isolt/AD-15-detector/1.jpg

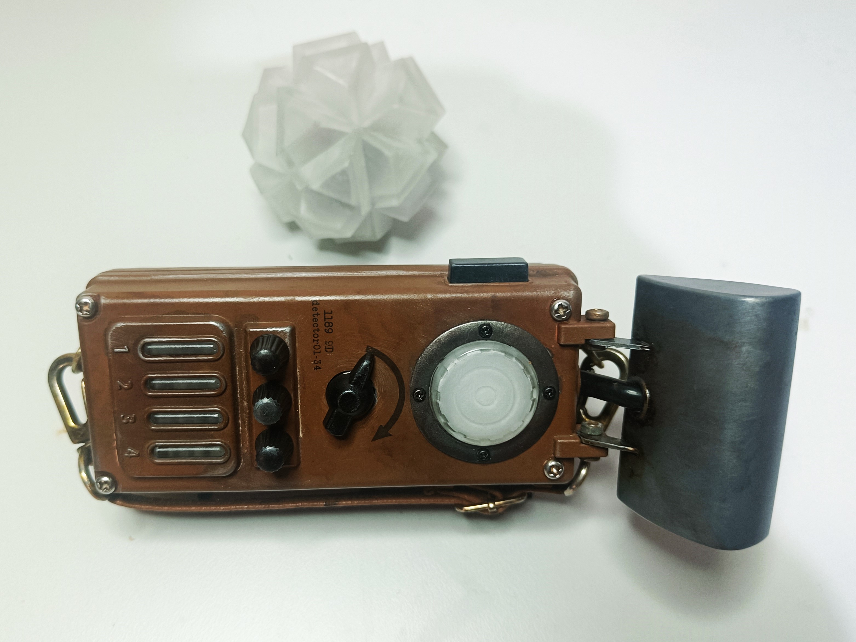
1.jpg
