isolt/AD-15-detector/README.md

# AD-15-detector
Geiger counter like prop from the game "into the radius"
