isolt/AD-15-detector/artifact/Artifact1-Module Cover.STL

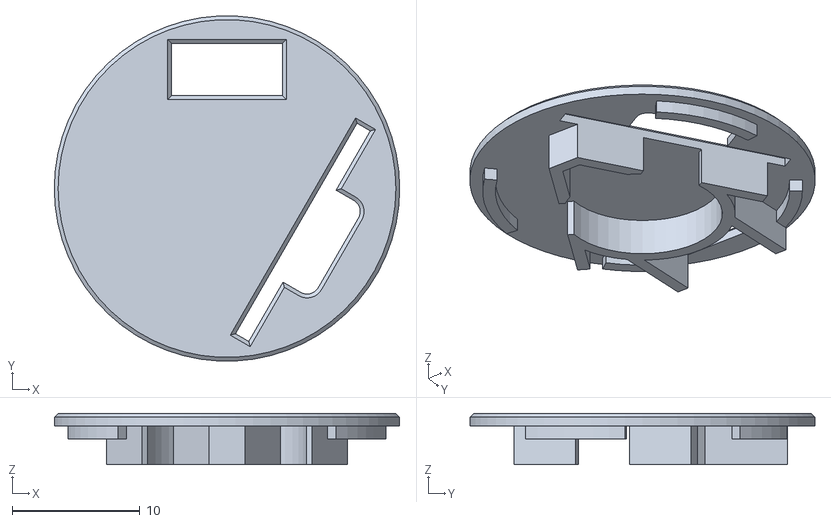
[picture p2: CAD file, 2024-11-29]
artifact/Artifact1-Module Cover.STL
27.0 x 27.0 x 4.00
