isolt/AD-15-detector/detector/DetectorV1-Indicator Diffuser.STL

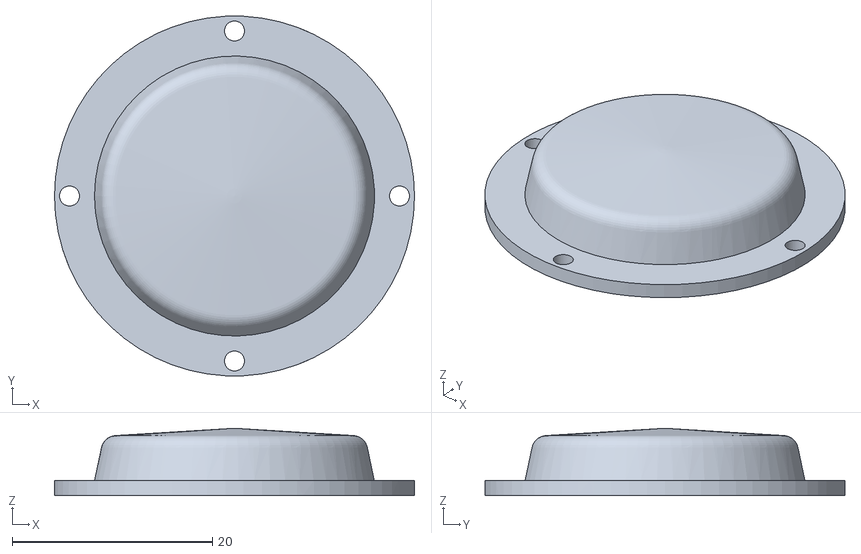
[picture p3: CAD file, 2024-11-29]
detector/DetectorV1-Indicator Diffuser.STL
36.0 x 36.0 x 6.70
