isolt/AD-15-detector/artifact/Artifact1-Module shell.STL

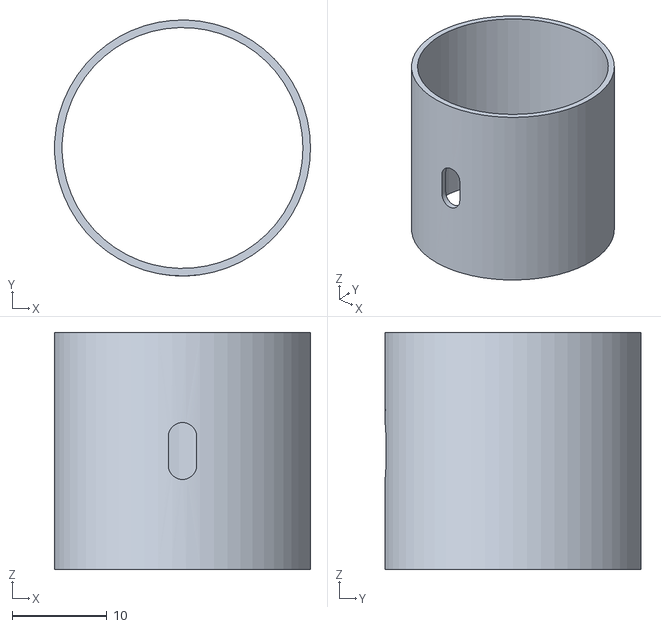
[picture p4: CAD file, 2024-11-29]
artifact/Artifact1-Module shell.STL
27.0 x 27.0 x 25.0
