isolt/AD-15-detector/detector/DetectorV1-Indicator Retainer.STL

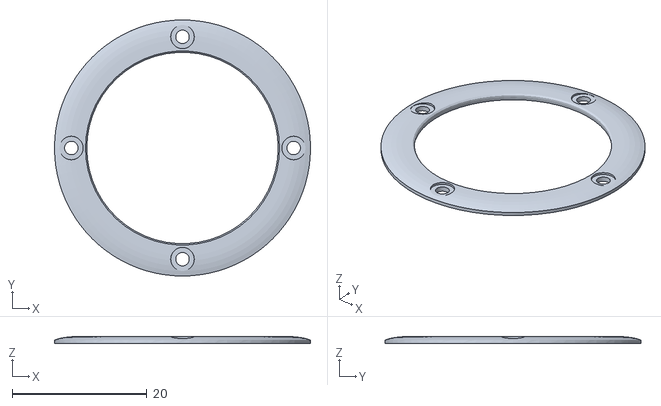
[picture p5: CAD file, 2024-11-29]
detector/DetectorV1-Indicator Retainer.STL
38.0 x 38.0 x 1.00
