isolt/AD-15-detector/artifact/Artifact1-Base.STL

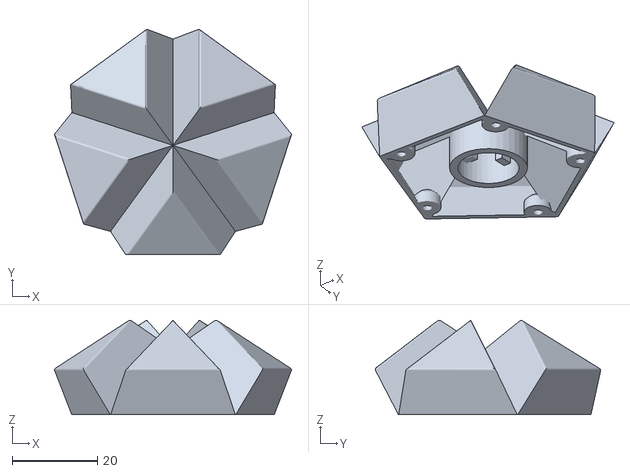
[picture p6: CAD file, 2024-11-29]
artifact/Artifact1-Base.STL
55.5 x 52.8 x 22.1
