isolt/AD-15-detector/detector/DetectorV1-Flash Diffuser.STL

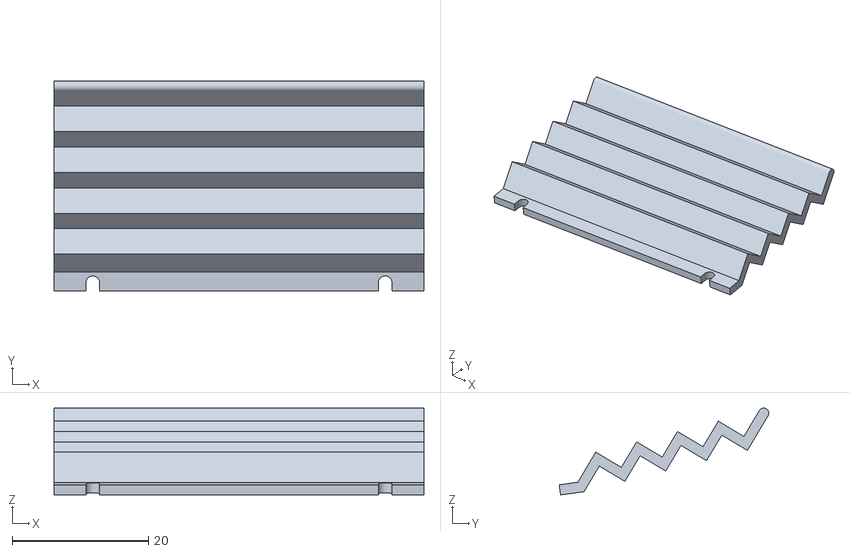
[picture p7: CAD file, 2024-11-29]
detector/DetectorV1-Flash Diffuser.STL
54.4 x 30.8 x 12.8
