isolt/AD-15-detector/artifact/Artifact1-Top.STL

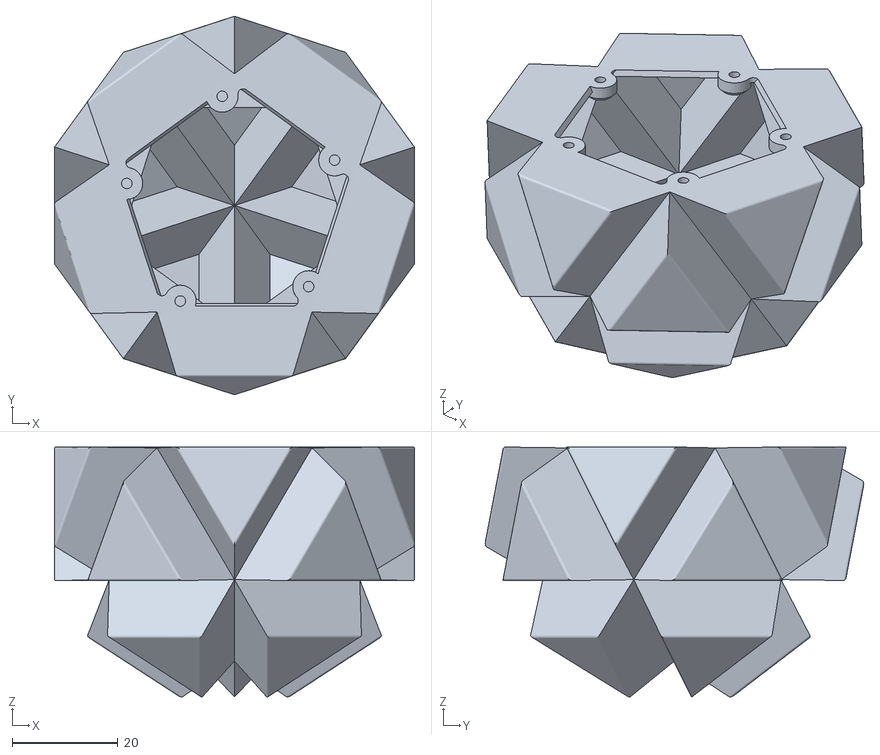
[picture p8: CAD file, 2024-11-29]
artifact/Artifact1-Top.STL
68.0 x 71.5 x 47.2
