isolt/AD-15-detector/detector/DetectorV1-Body Top.STL

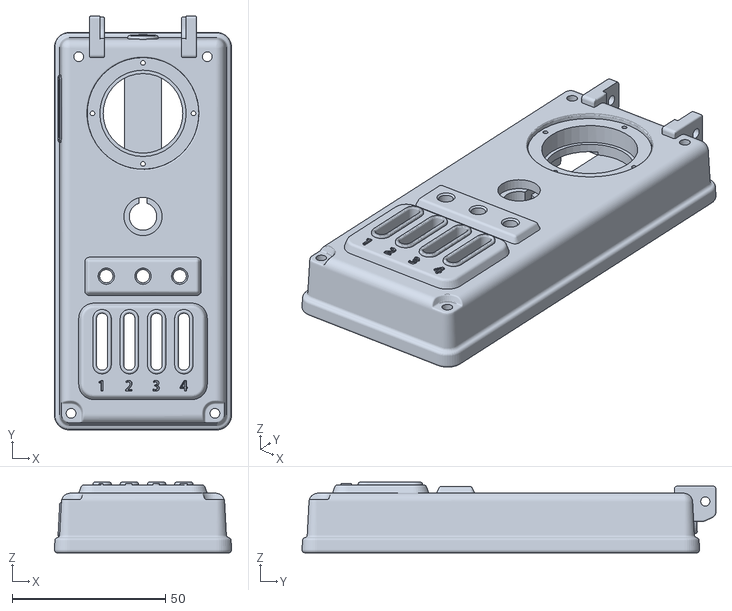
[picture p9: CAD file, 2024-11-29]
detector/DetectorV1-Body Top.STL
57.9 x 135.2 x 23.1
