isolt/AD-15-detector/artifact/Artifact1.STEP

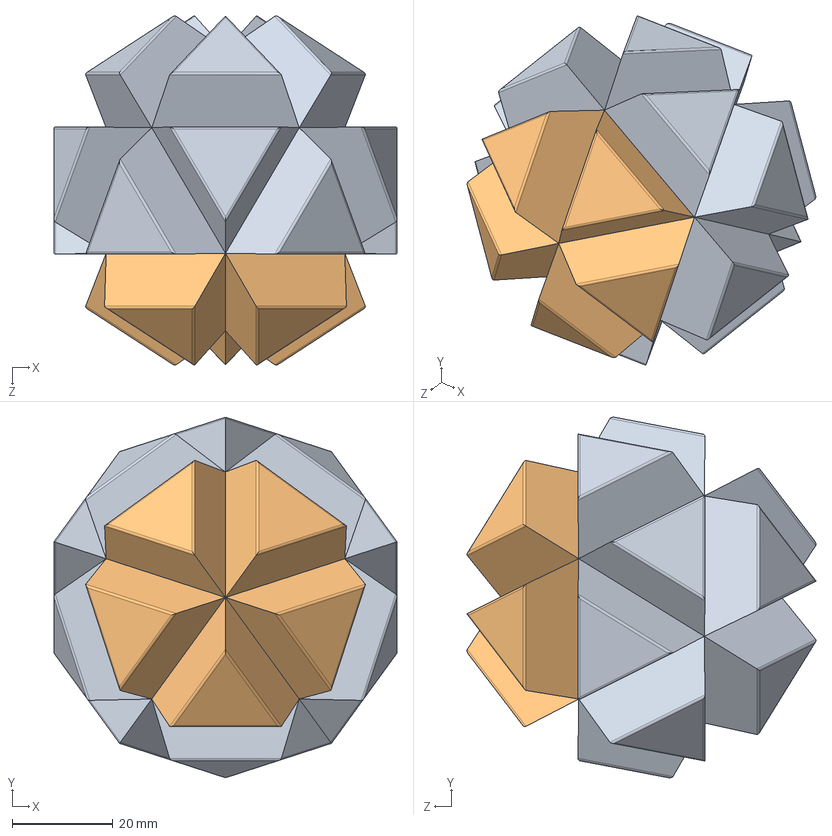
[picture p10: CAD file, 2024-11-29]
artifact/Artifact1.STEP
68.0 x 71.5 x 69.2 mm
artifact1_TOP
artifact1_base
BATTERY MODULE
battery2
PIXEL
5V board
ESP32 Super Mini
Part70^ARTIFACT MODULE
