isolt/AD-15-detector/detector/DetectorV1-Stand.STL

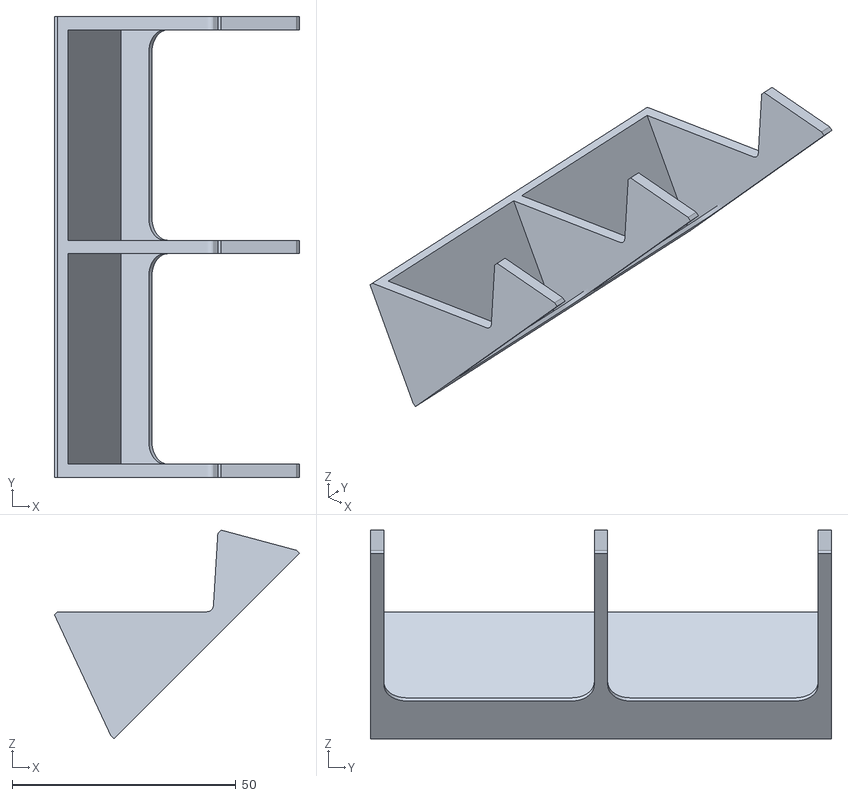
[picture p11: CAD file, 2024-11-29]
detector/DetectorV1-Stand.STL
54.7 x 103.0 x 46.7
