isolt/AD-15-detector/detector/DetectorV1-Flash Button.STL

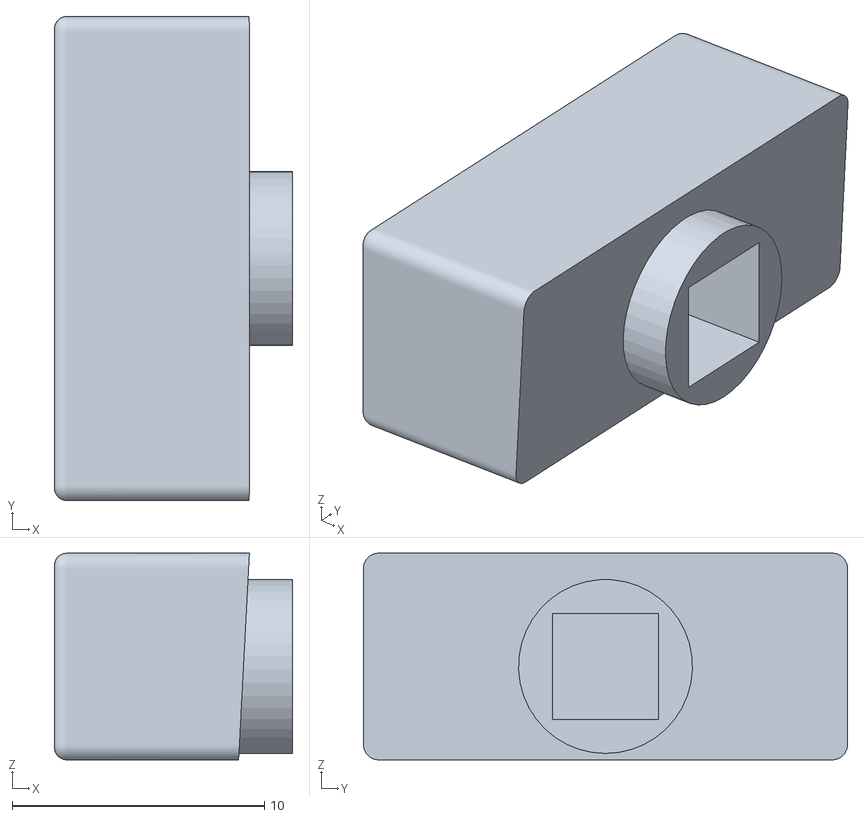
[picture p12: CAD file, 2024-11-29]
detector/DetectorV1-Flash Button.STL
9.45 x 19.2 x 8.20
