isolt/AD-15-detector/detector/DetectorV1-Distance Indicator LED Mount.STL

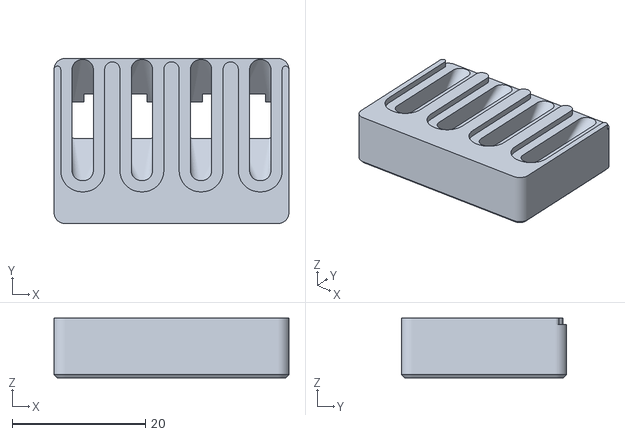
[picture p13: CAD file, 2024-11-29]
detector/DetectorV1-Distance Indicator LED Mount.STL
35.3 x 24.8 x 9.00
