isolt/AD-15-detector/detector/DetectorV1-Brass knob.STL

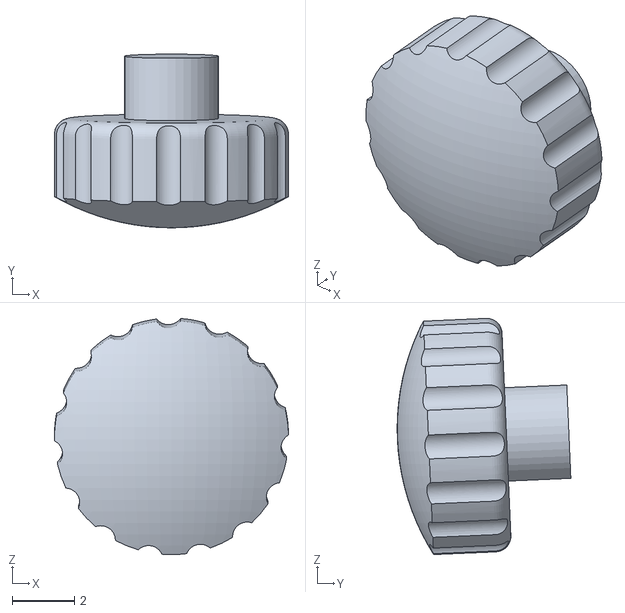
[picture p14: CAD file, 2024-11-29]
detector/DetectorV1-Brass knob.STL
7.50 x 5.57 x 7.57
