isolt/AD-15-detector/detector/name plate1.dxf

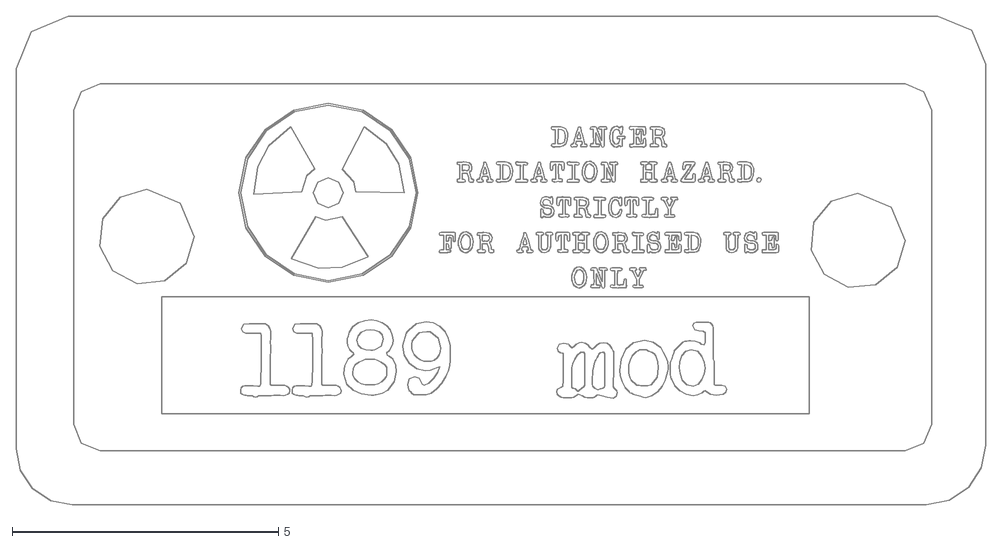
[picture p15: CAD file, 2024-11-29]
detector/name plate1.dxf
18.2 x 9.18
