isolt/AD-15-detector/detector/DetectorV1-Adjustment Knob.STL

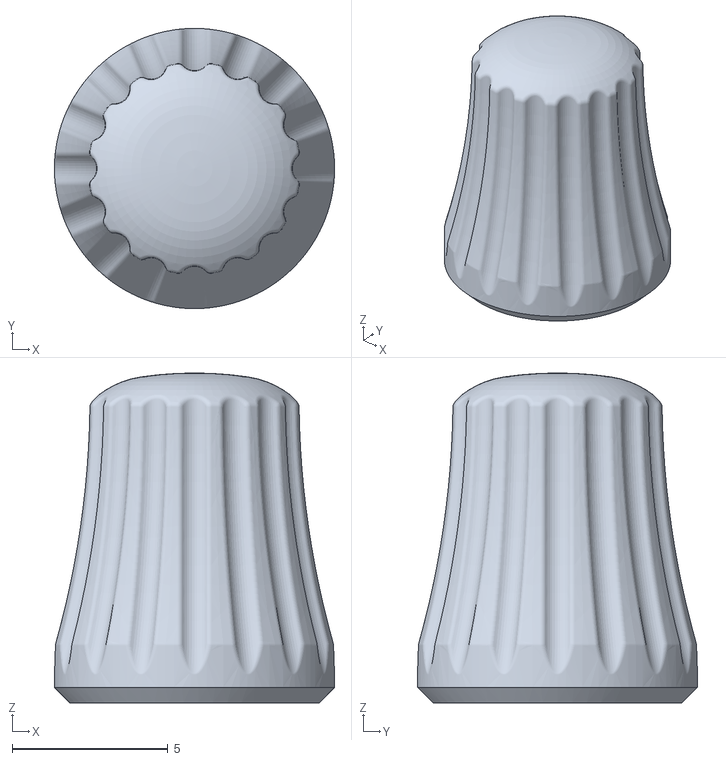
[picture p16: CAD file, 2024-11-29]
detector/DetectorV1-Adjustment Knob.STL
9.00 x 9.00 x 10.6
