isolt/AD-15-detector/detector/DetectorV1-Flash Housing.STL

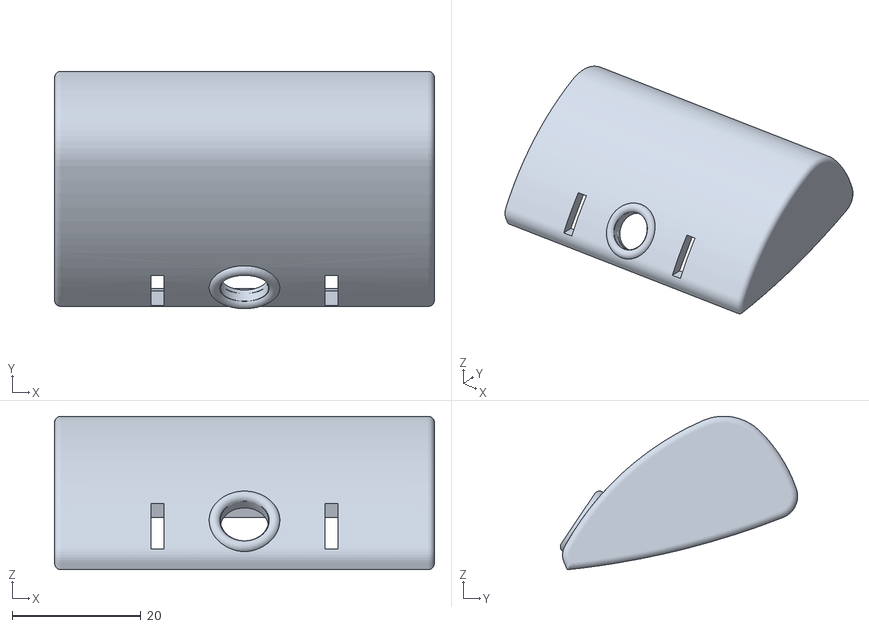
[picture p17: CAD file, 2024-11-29]
detector/DetectorV1-Flash Housing.STL
59.0 x 36.8 x 23.8
