isolt/AD-15-detector/detector/DetectorV1-Body Base.STL

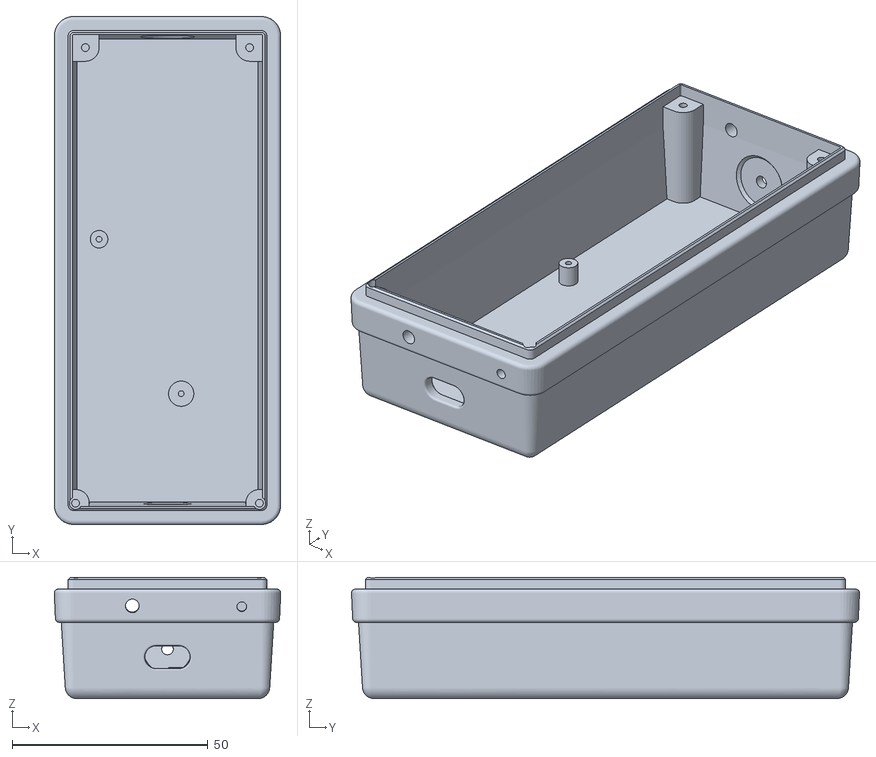
[picture p18: CAD file, 2024-11-29]
detector/DetectorV1-Body Base.STL
57.9 x 129.9 x 31.0
