isolt/AD-15-detector/detector/DetectorV1-Distance Indicator Diffuser.STL

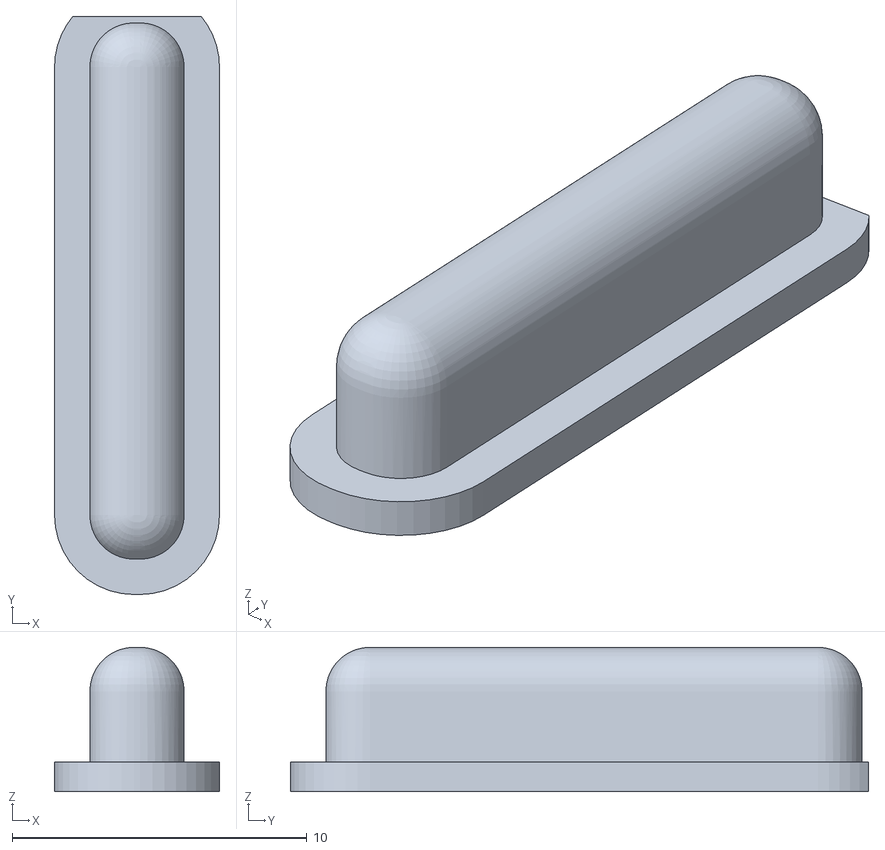
[picture p19: CAD file, 2024-11-29]
detector/DetectorV1-Distance Indicator Diffuser.STL
5.60 x 19.6 x 4.90
