isolt/AD-15-detector/detector/DetectorV1-Flash Bracket.STL

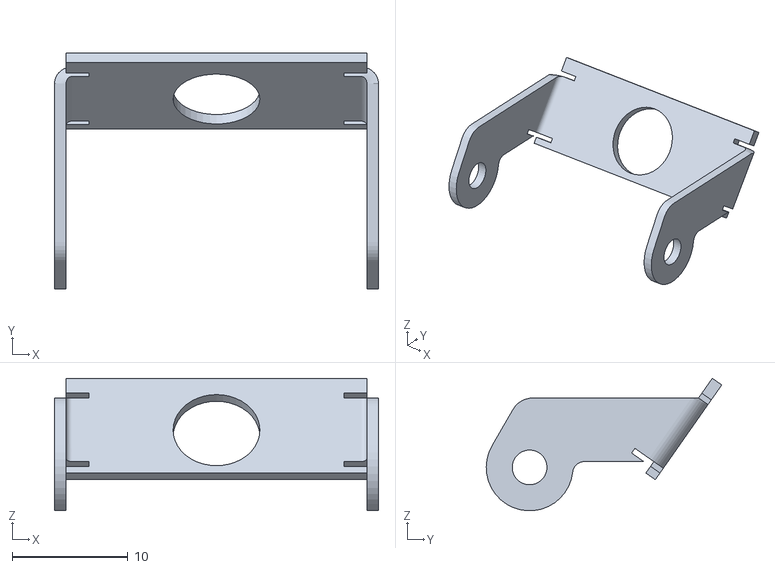
[picture p20: CAD file, 2024-11-29]
detector/DetectorV1-Flash Bracket.STL
28.0 x 20.4 x 11.4
