isolt/AD-15-detector/detector/DetectorV1-Selection Knob.STL

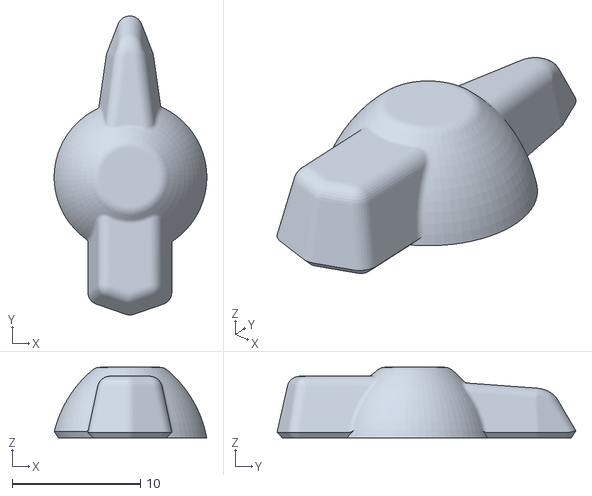
[picture p21: CAD file, 2024-11-29]
detector/DetectorV1-Selection Knob.STL
11.9 x 23.3 x 5.50
