isolt/AD-15-detector/MANUAL V2.pdf

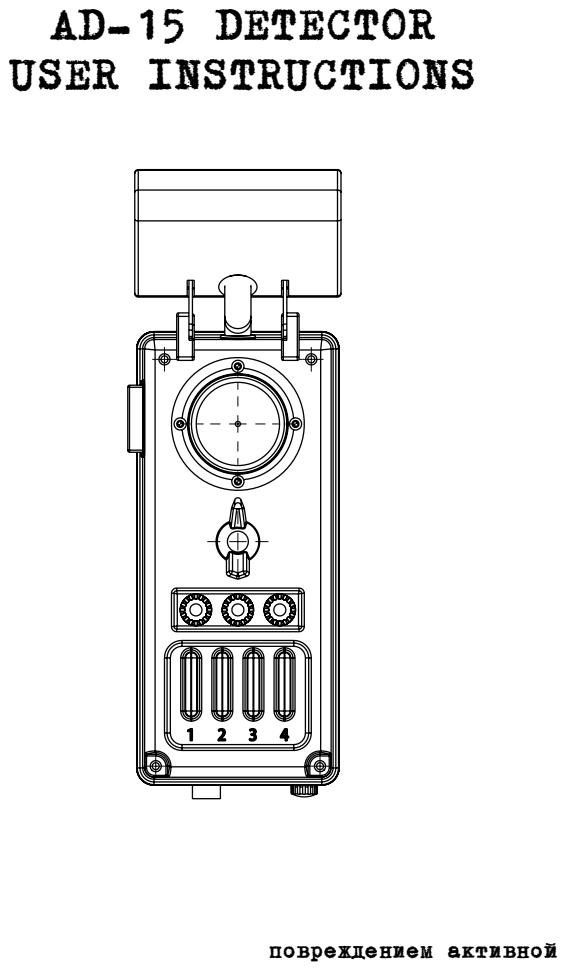
[picture p34: page 1]
AD-15 DETECTOR USER INSTRUCTIONS; повреждением активной

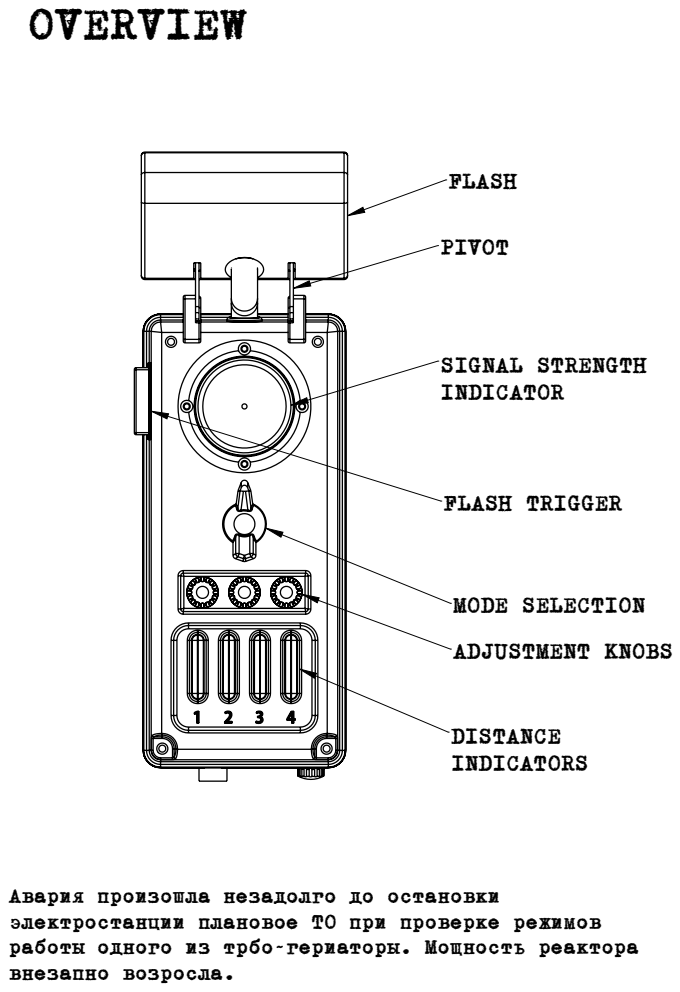
[picture p35: page 3]
SIGNAL STRENGTH; FLASH TRIGGER; MODE SELECTION; ADJUSTMENT KNOBS

Авария произошла незадолго до остановки
электростанции плановое ТО при проверке режимов
работы одного из трбо~гериаторы. Мощность реактора
внезапно возросла.

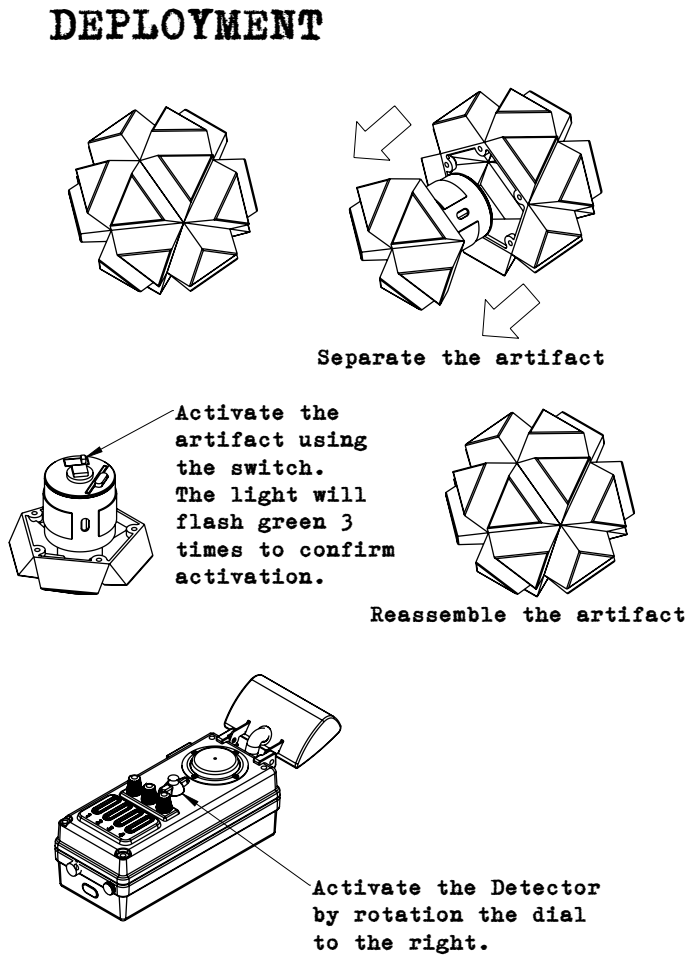
[picture p36: page 4]

Separate the artifact

Activate the
artifact using
the switch.
The light will
flash green 3
times to confirm
activation.

Reassemble the artifact

Activate the Detector
by rotation the dial
to the right.

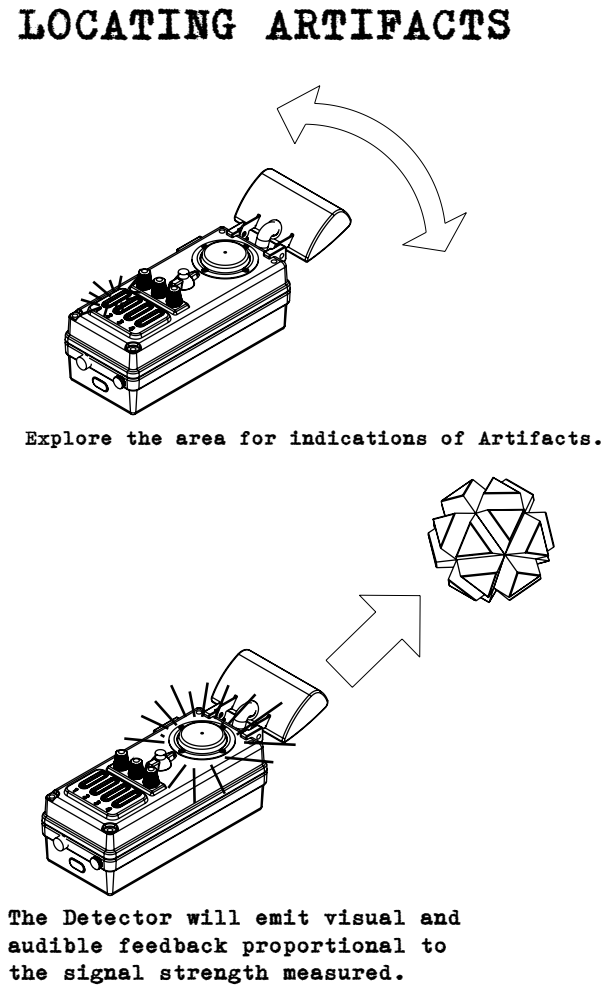
[picture p37: page 5]
LOCATING ARTIFACTS

Explore the area for indications of Artifacts.

The Detector will emit visual and
audible feedback proportional to
the signal strength measured.

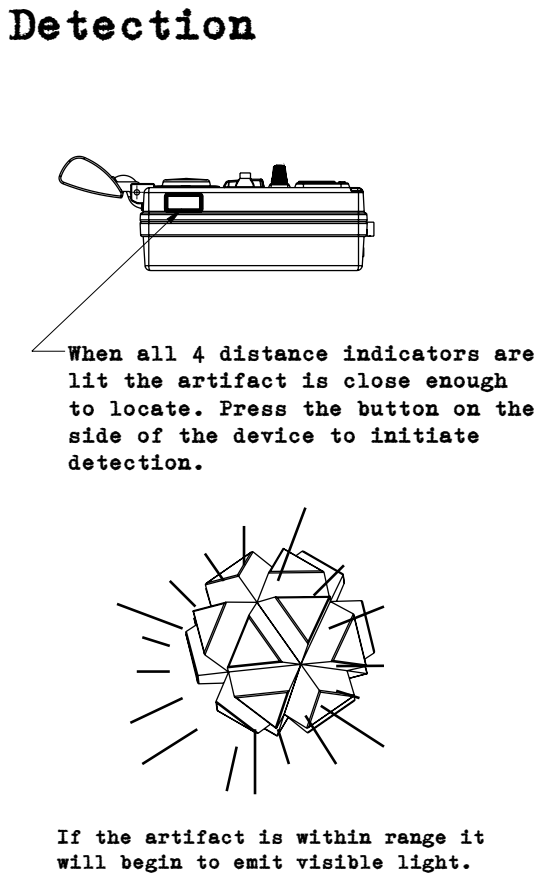
[picture p38: page 6]

When all 4 distance indicators are
lit the artifact is close enough
to locate. Press the button on the
side of the device to initiate
detection.

If the artifact is within range it
will begin to emit visible light.

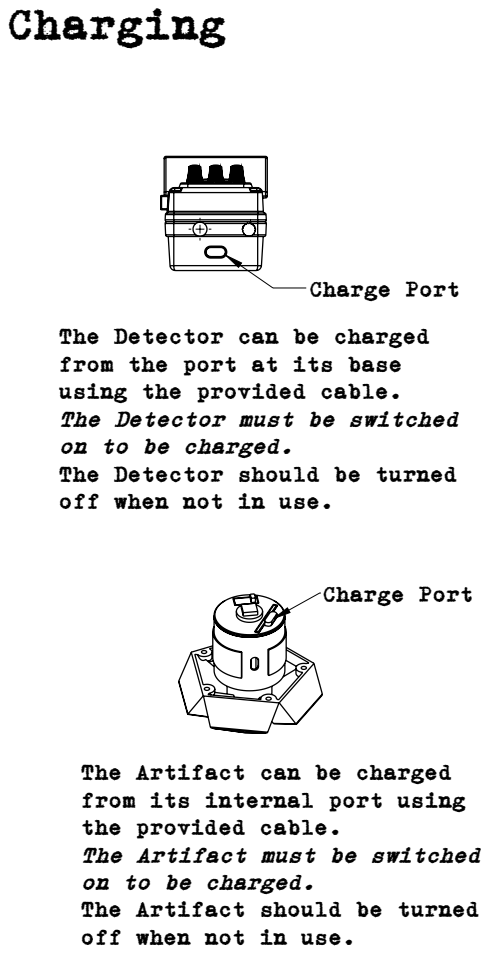
[picture p39: page 7]
Charge Port

The Detector can be charged
from the port at its base
using the provided cable.
The Detector must be switched
on to be charged.
The Detector should be turned
off when not in use.

The Artifact can be charged
from its internal port using
the provided cable.
The Artifact must be switched
The Artifact should be turned

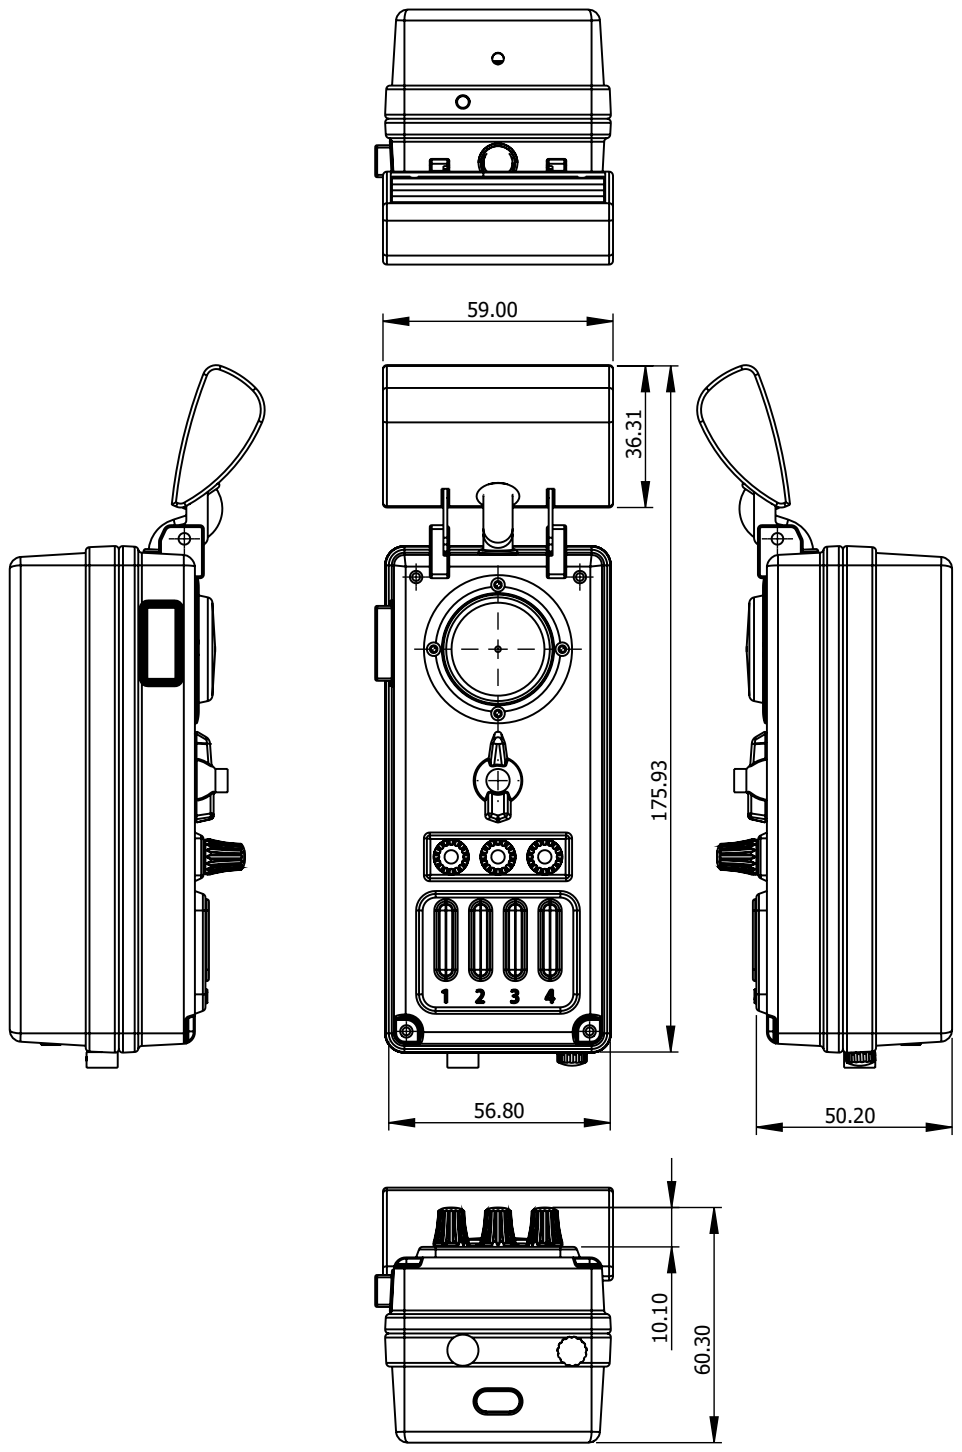
[picture p40: page 8]
