isolt/AD-15-detector/detector/DetectorV1-Flash Bracket A4.pdf

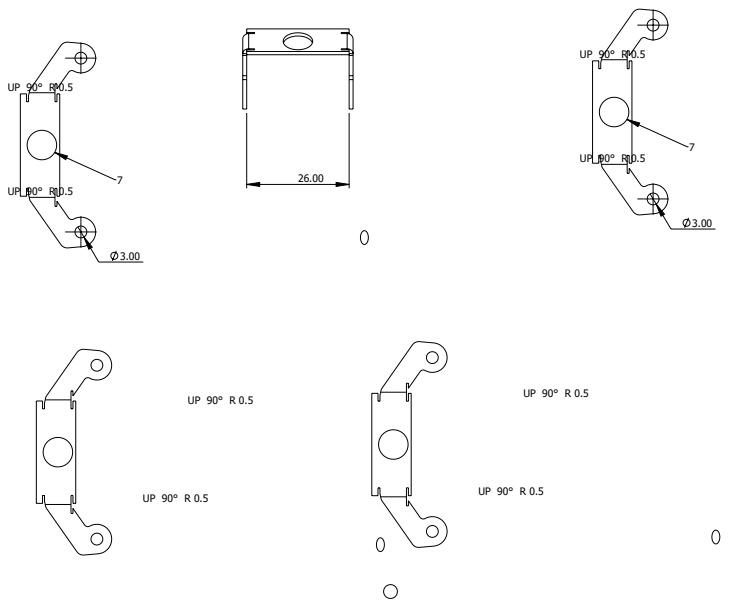
[picture p41: page 1]
